mian-zhi/XiaoMaAirFly/hardware/v1.3/BOM_v1.3_PCB.xlsx

No. | Quantity | Comment | Designator | Footprint | Value | Manufacturer Part | Manufacturer | Supplier Part | Supplier
1 | 7 | 100nF | C1,C2,C3,C4,C5,C19,C21 | C0603 | 100nF | CC0603KRX7R9BB104 | YAGEO(国巨) | C14663 | LCSC
2 | 2 | 20pF | C6,C7 | C0603 | 20pF | CL10C200JB8NNNC | SAMSUNG(三星) | C1648 | LCSC
3 | 2 | 1uF | C10,C11 | C0603 | 1uF | CL10A105KB8NNNC | SAMSUNG(三星) | C15849 | LCSC
4 | 2 | 22uF | C17,C18 | C0805 | 22uF | CL21A226MAQNNNE | SAMSUNG(三星) | C45783 | LCSC
5 | 1 | 2.2nF | C20 | C0603 | 2.2nF | 0603B222K500NT | FH(风华) | C1604 | LCSC
6 | 1 | HX25003-2A | CN4 | CONN-TH_2P-P2.50_HX25003-2A |  | HX25003-2A | HX(红星) | C442299 | LCSC
7 | 4 | B5819W SL | D1,D2,D3,D4 | SOD-123_L2.7-W1.6-LS3.7-RD-1 |  | B5819W SL | CJ(江苏长电/长晶) | C8598 | LCSC
8 | 4 |  | H1,H2,H3,H4 | HDR-TH_2P-P2.54-V-F |  |  |  | C49661
9 | 3 | GH1.25-4P | J1,J2,J3 | CONN-SMD_4P-P1.25_GH1.25-4PLI |  | GH1.25-4P |  | C9900017110 | LCSC
10 | 1 | GH1.25MM-3P-SMT-LI | J4 | CONN-SMD_3P-P1.25_GH1.25-3PLI |  | GH1.25MM-3P-SMT-LI |  | C9900017112 | LCSC
11 | 1 | ME6211C33M5G-N | LDO1 | SOT-23-5_L3.0-W1.7-P0.95-LS2.8-BL |  | ME6211C33M5G-N | MICRONE(南京微盟) | C82942 | LCSC
12 | 1 |  | OLED1 | 0.96OLED_4P
13 | 2 | TLMS1000-GS08 | PWR,STATE | LED0603-R-RD |  | TLMS1000-GS08 | VISHAY(威世) | C241893 | LCSC
14 | 4 | SI2302 | Q1,Q2,Q3,Q4 | SOT-23-3_L2.9-W1.3-P1.90-LS2.4-BR |  | SI2302 | TECH PUBLIC(台舟) | C2841377 | LCSC
15 | 1 | 0Ω | R1 | R0603 | 0Ω | 0603WAF0000T5E | UNI-ROYAL(厚声) | C21189 | LCSC
16 | 7 | 10kΩ | R2,R3,R9,R11,R13,R15,R19 | R0603 | 10kΩ | 0603WAF1002T5E | UNI-ROYAL(厚声) | C25804 | LCSC
17 | 4 | 1kΩ | R4,R5,R16,R17 | R0603 | 1kΩ | 0603WAF1001T5E | UNI-ROYAL(厚声) | C21190 | LCSC
18 | 4 | 100Ω | R8,R10,R12,R14 | R0603 | 100Ω | 0603WAF1000T5E | UNI-ROYAL(厚声) | C22775 | LCSC
19 | 1 | 20kΩ | R18 | R0603 | 20kΩ | 0603WAF1002T5E | UNI-ROYAL(厚声) |  | LCSC
20 | 3 | B3U-1000P | SW0,SW1,SW2 | KEY-SMD_B3U-1000PM |  | B3U-1000P | OMRON(欧姆龙) | C231329 | LCSC
21 | 1 | SC12P-AVR | SW5 | SW-TH_SC12P-AVR |  | SC12P-AVR | 圜达 | C240300 | LCSC
22 | 1 | STM32F103C8T6 | U1 | LQFP-48_L7.0-W7.0-P0.50-LS9.0-BL |  | STM32F103C8T6 | ST(意法半导体) | C8734 | LCSC
23 | 1 | MPU-6050 | U4 | QFN-24_L4.0-W4.0-P0.50-BL-EP2.7 |  | MPU-6050 | TDK InvenSense(应美盛) | C24112 | LCSC
24 | 1 | 8MHz | X1 | CRYSTAL-SMD_L5.0-W3.2 | 8MHz | X50328MSB2GI | YXC(扬兴晶振) | C115962 | LCSC
