mian-zhi/XiaoMaAirFly/(threads)

Thread 2 (2023-04-05):

Interrupt request handle function of TIM2

akawincent, 2023-04-05:
### _**tim_delay**_ probably causes bug!!

```c
void HAL_TIM_PeriodElapsedCallback(TIM_HandleTypeDef *htim)
{
	if(htim->Instance == htim2.Instance) //5ms
	{
		static int16_t tim_delay = 0;
		static vector3i_t acce , gyro ;
		static euler_t pose;
		tim_delay++;
		if(tim_delay%2 == 0) // 1ms * 500 = 500ms
		{
			mpu_data_update(&acce , &gyro ,1 ,1 ,0);
			algorithm_pose(&acce , &gyro , &pose , algorithm_pose_acce_only);
		}
	}
}

```
As the program runs, there is a risk that “tim_delay” variables will overflow.

mian-zhi, 2023-04-05:
OK!I will fix it SOON

akawincent, 2023-05-06:
I have fixed this bug.

Closed 2023-05-06.

Thread 6 (2023-05-14):

Runge Kutta method BUG

mian-zhi, 2023-05-14:
There is a little problem with the Runge Kutta method, the update of the pitch angle is not normal @akawincent
