mian-zhi/XiaoMaAirFly/hardware/v1.3/assembly diagram_v1.3.pdf

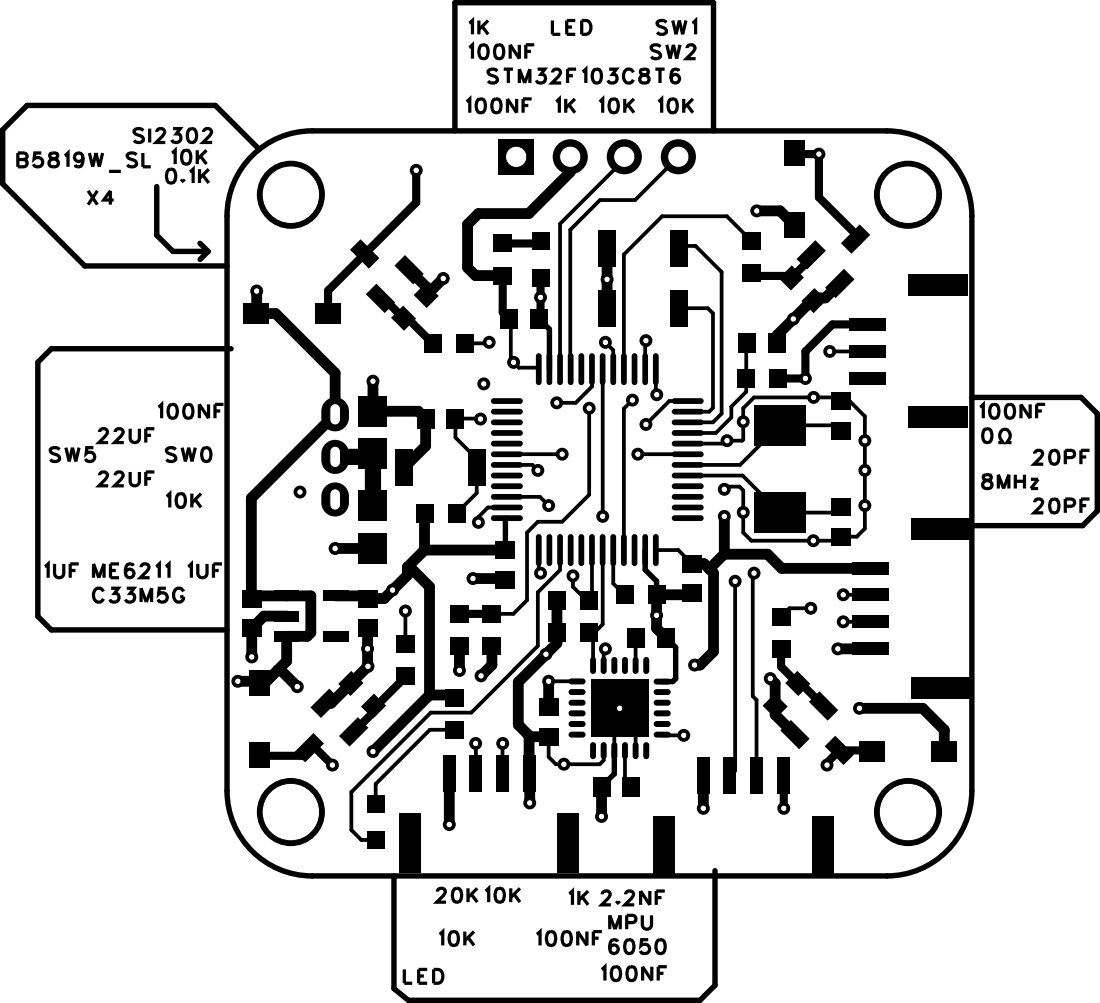
[picture p1: page 1]
