mian-zhi/XiaoMaAirFly/hardware/v1.3/XiaoMaAirFly_v1.3.pdf

# v1.3版本飞控

改动:

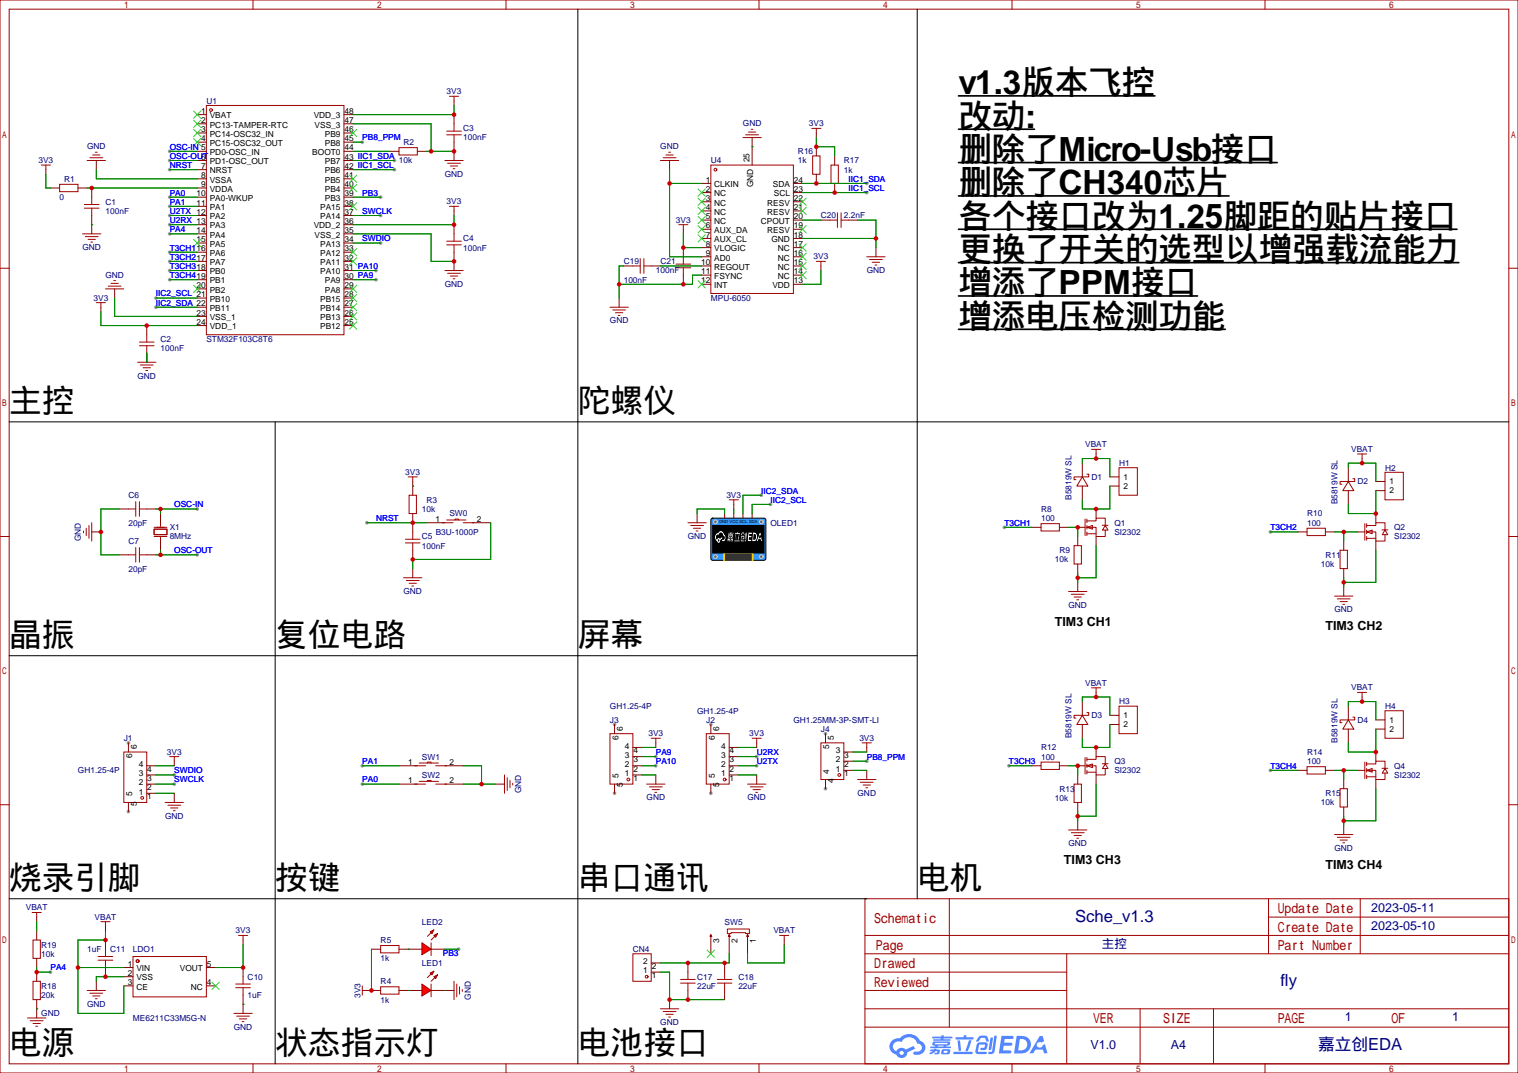
[picture p2: page 1]
