mian-zhi/XiaoMaAirFly/hardware/v1.1/XiaoMaAirFly_v1.1.pdf

串口

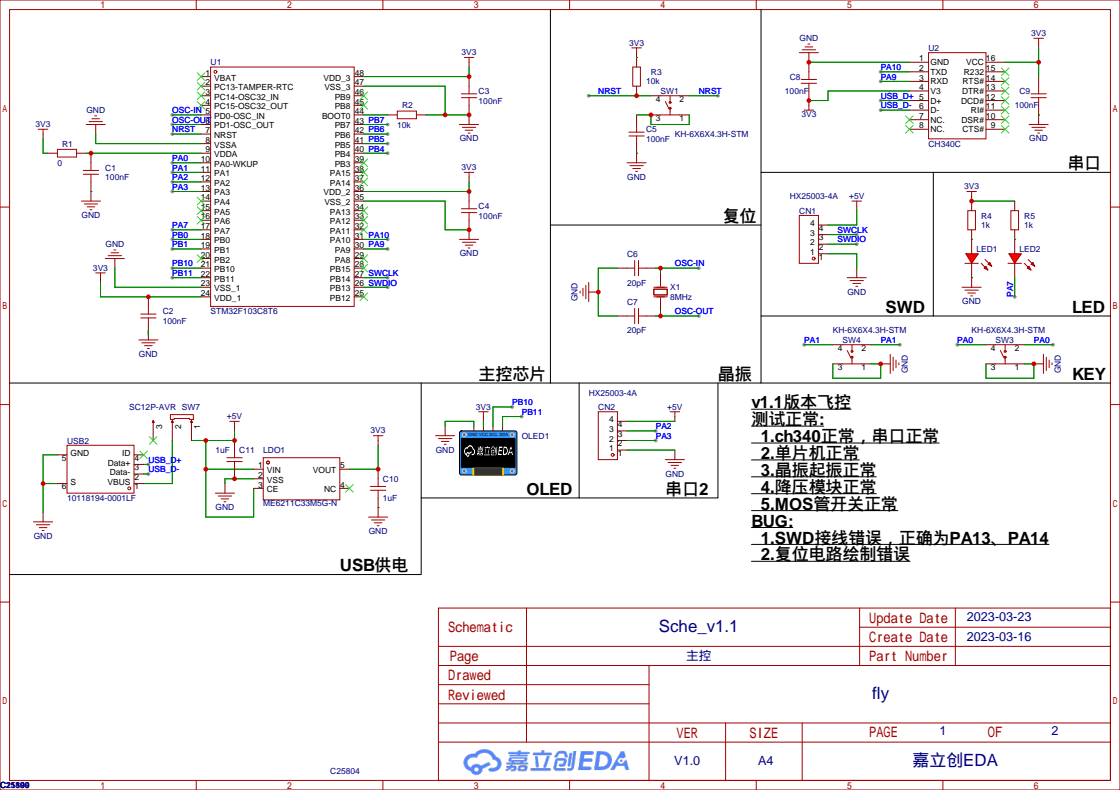
[picture p3: page 1]

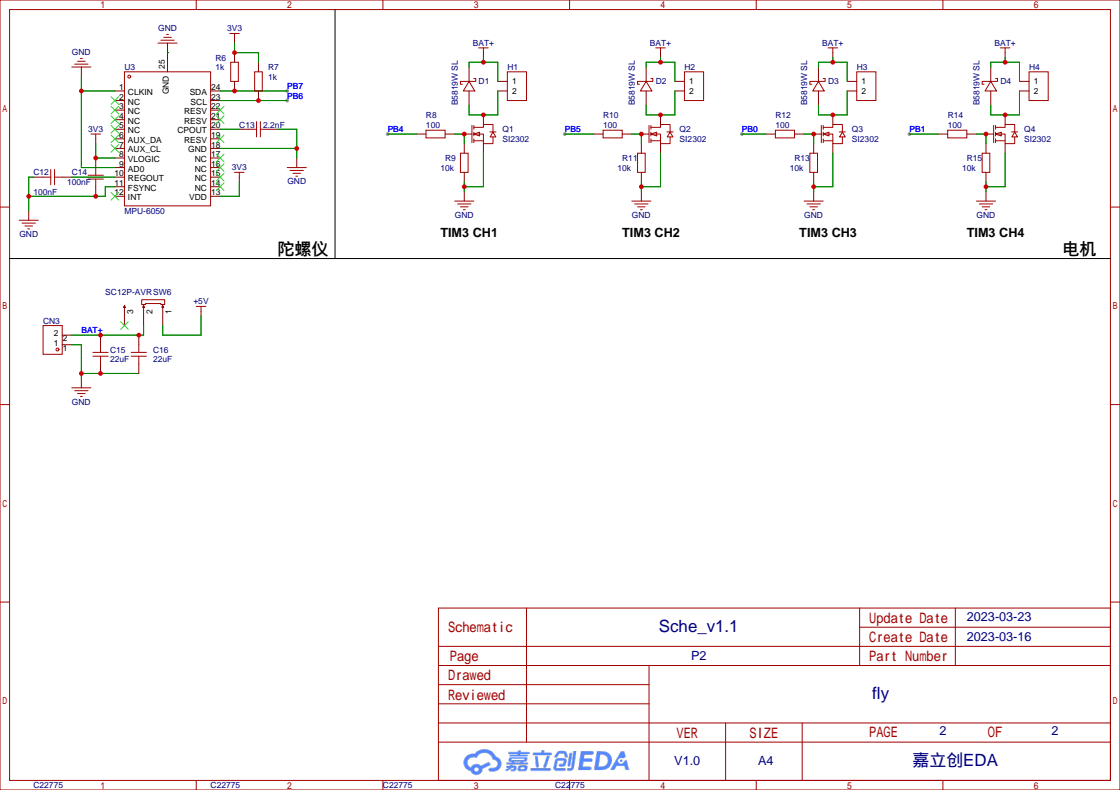
[picture p4: page 2]
