mian-zhi/XiaoMaAirFly/hardware/v1.2/XiaoMaAirFly_v1.2.pdf

串口

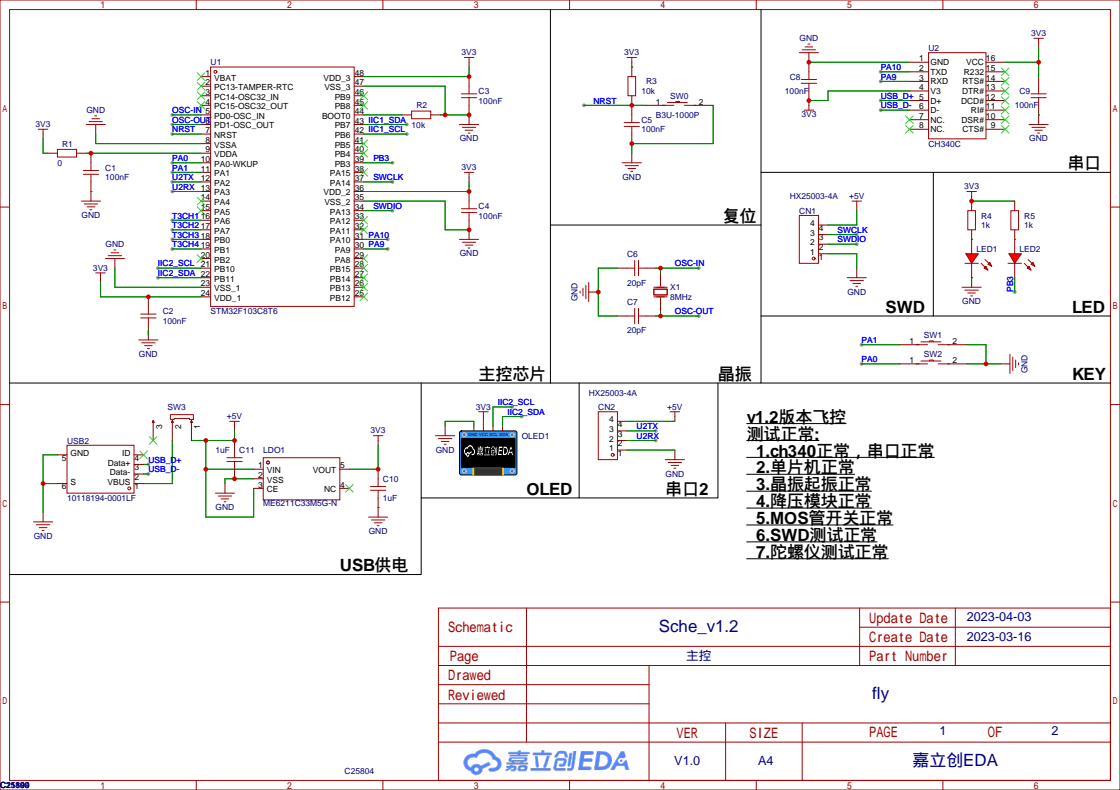
[picture p5: page 1]

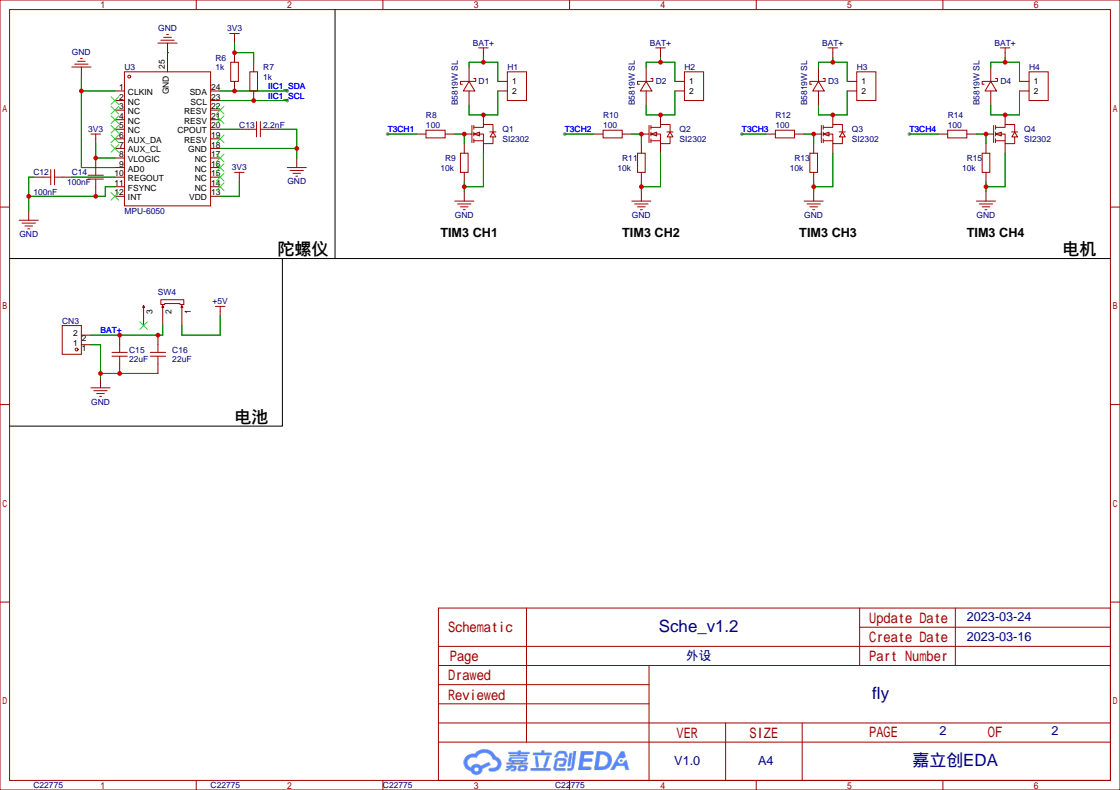
[picture p6: page 2]
