mian-zhi/XiaoMaAirFly/(commit log)

2023-04-05 Integrate the angular velocity to estimate pose
2023-04-05 Test of pose estimation using gyro is passed！
2023-04-07 add device code of oled by soft iic
2023-05-11 update hardware
    [BOM_v1.3_PCB.xlsx]
2023-05-15 Configure the motor and test it
